jacopomaroli/multisensor/pcb/prj_img/front3D.png

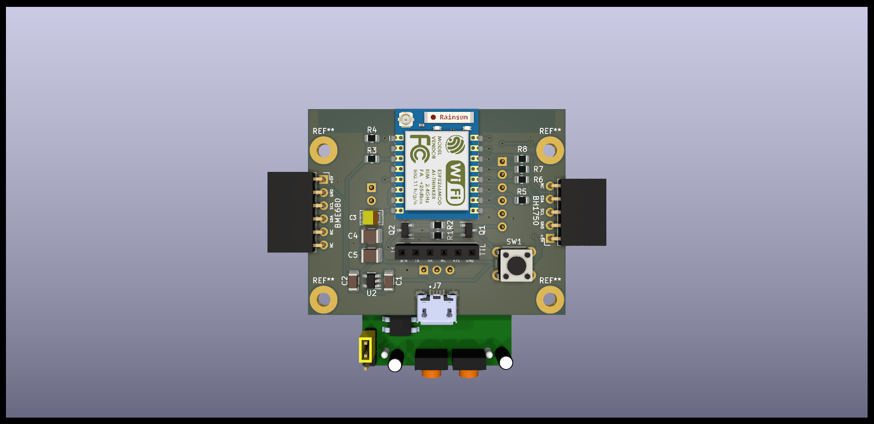
pcb/prj_img/front3D.png
