jacopomaroli/multisensor/pcb/prj_img/back3D_no_modules.png

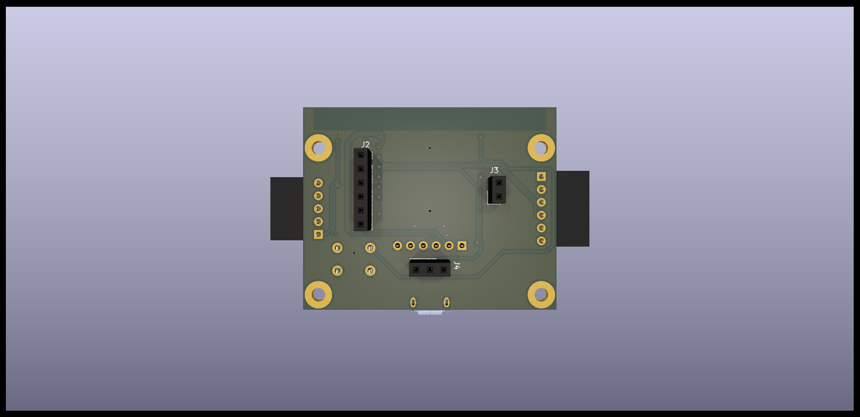
pcb/prj_img/back3D_no_modules.png
