jacopomaroli/multisensor/README.md

# Multisensor
This is a domotic project aimed to detect presence, temperature and light level in a room and share data with the rest of the ecosystem (e.g. homeassistant)

# Notes
VDO/CS of BME680 should be connected to GND
https://github.com/esphome/issues/issues/2421
