jacopomaroli/multisensor/pcb/notes.md

# Notes

Official KiCAD library has MMBT3904 symbol with the right SOT23 footprint, that is the smd variand of 2n3904
