jacopomaroli/multisensor/pcb/prj_img/back3D.png

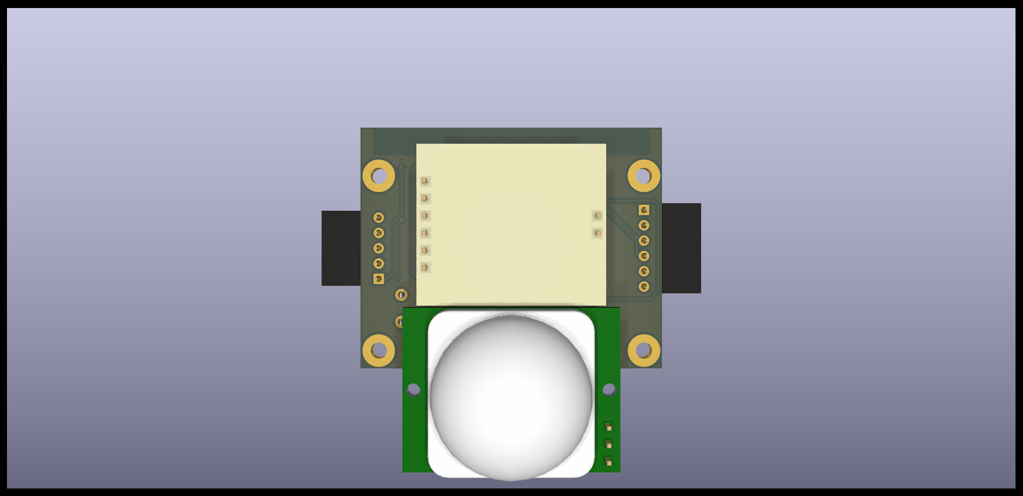
pcb/prj_img/back3D.png
