jacopomaroli/multisensor/pcb/prj_img/multisensor-B_Cu.png

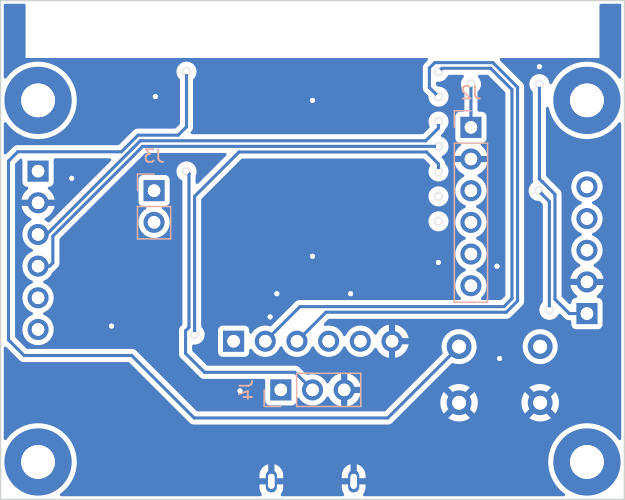
pcb/prj_img/multisensor-B_Cu.png
