jacopomaroli/multisensor/pcb/prj_img/multisensor-F_Cu.png

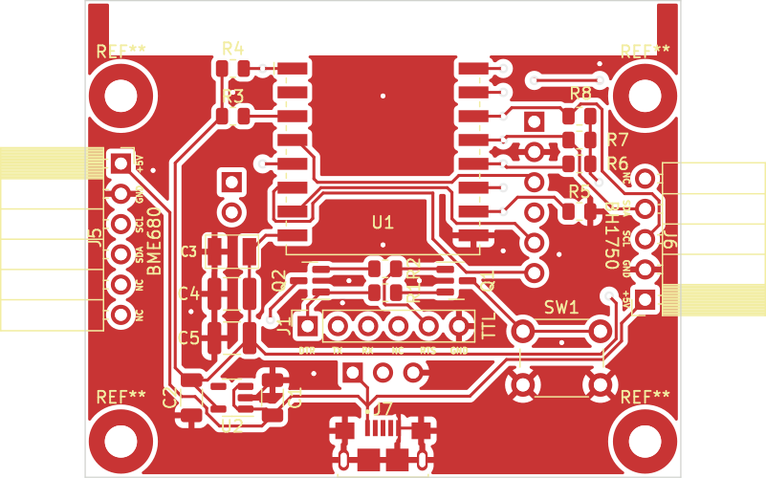
pcb/prj_img/multisensor-F_Cu.png
