jacopomaroli/multisensor/pcb/prj_img/multisensor.png

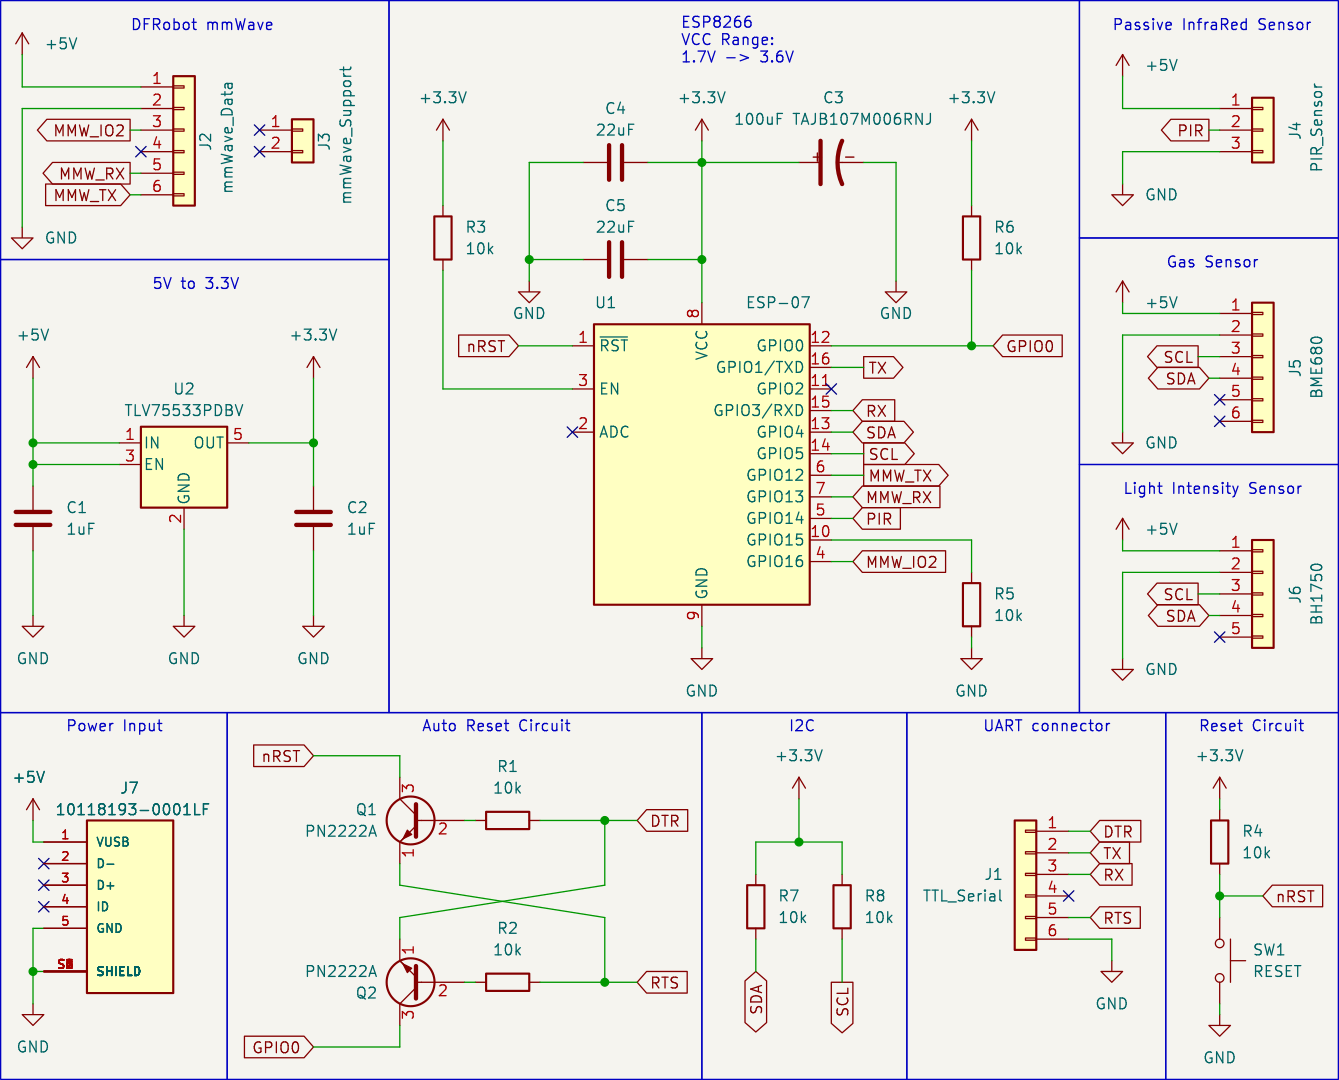
pcb/prj_img/multisensor.png
