jacopomaroli/multisensor/pcb/spice/sim1.png

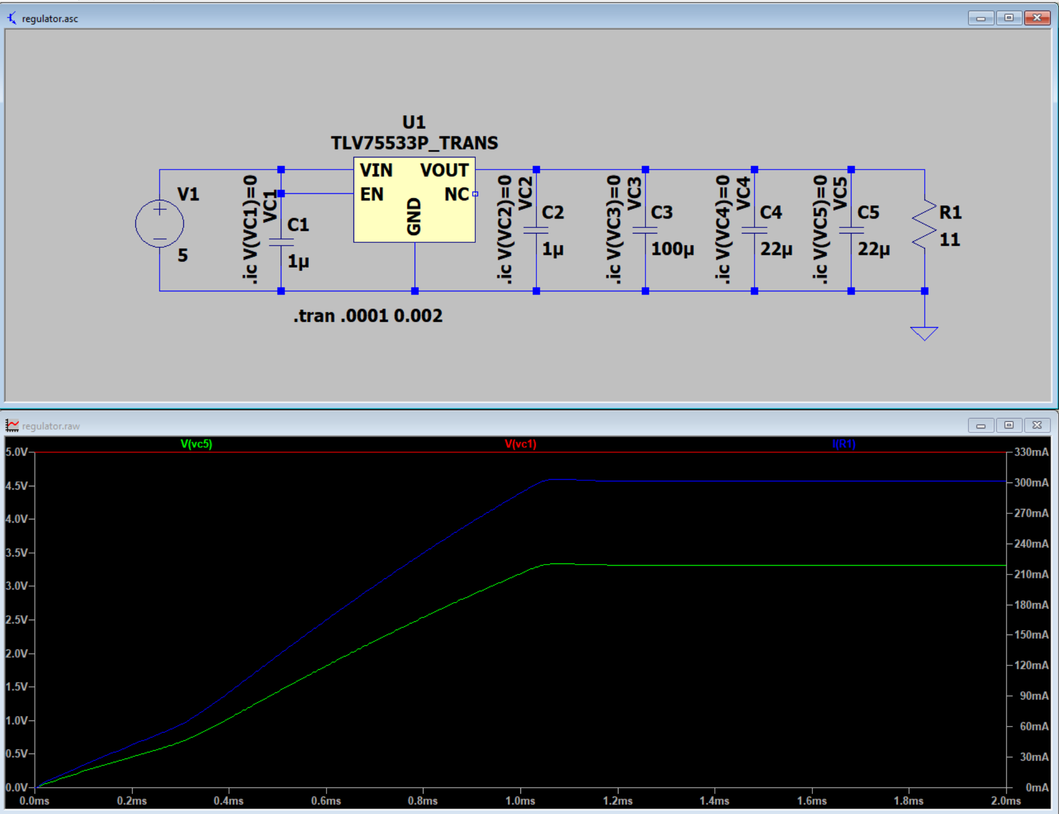
pcb/spice/sim1.png
