jacopomaroli/multisensor/pcb/spice/sim2.png

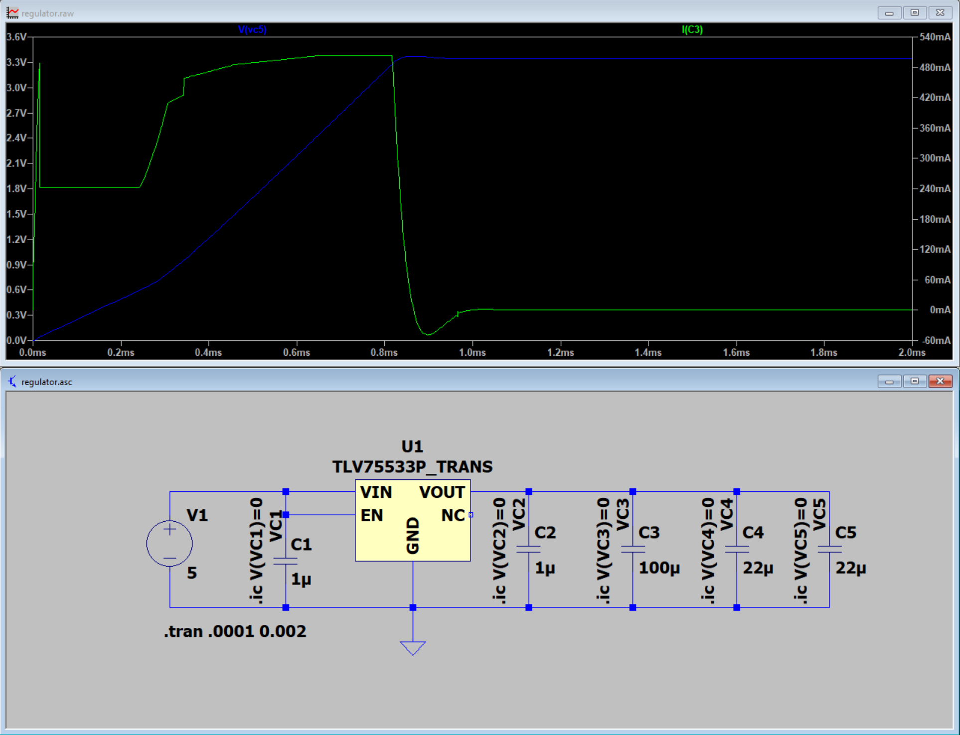
pcb/spice/sim2.png
