jacopomaroli/multisensor/pcb/spice/sim3.png

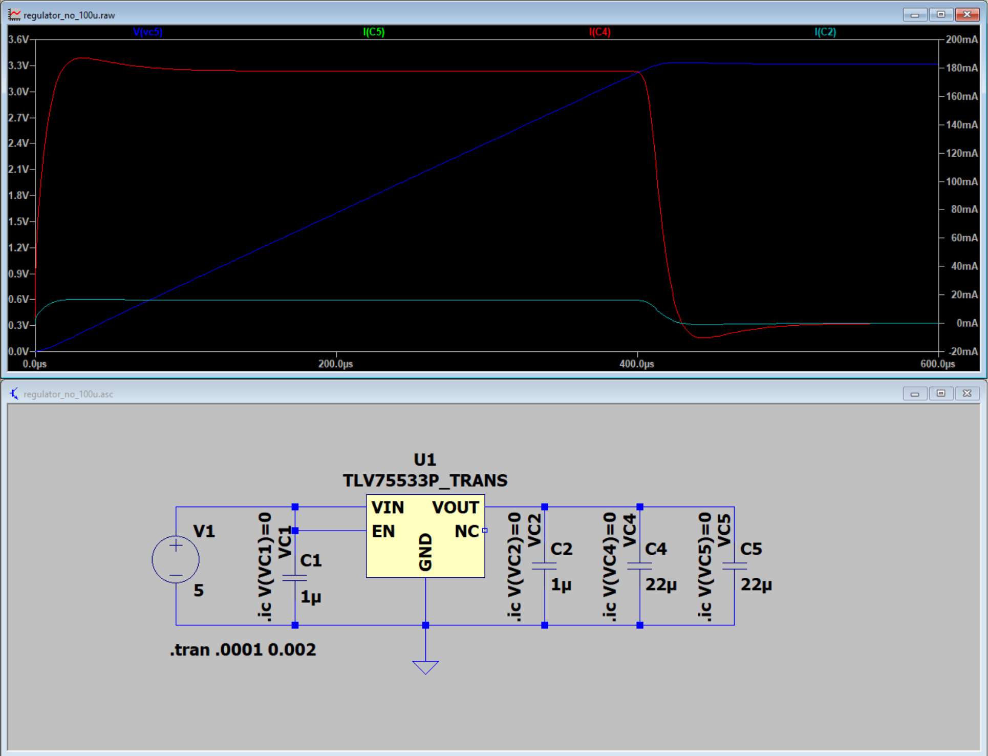
pcb/spice/sim3.png
