jacopomaroli/multisensor/pcb/spice/sim4.png

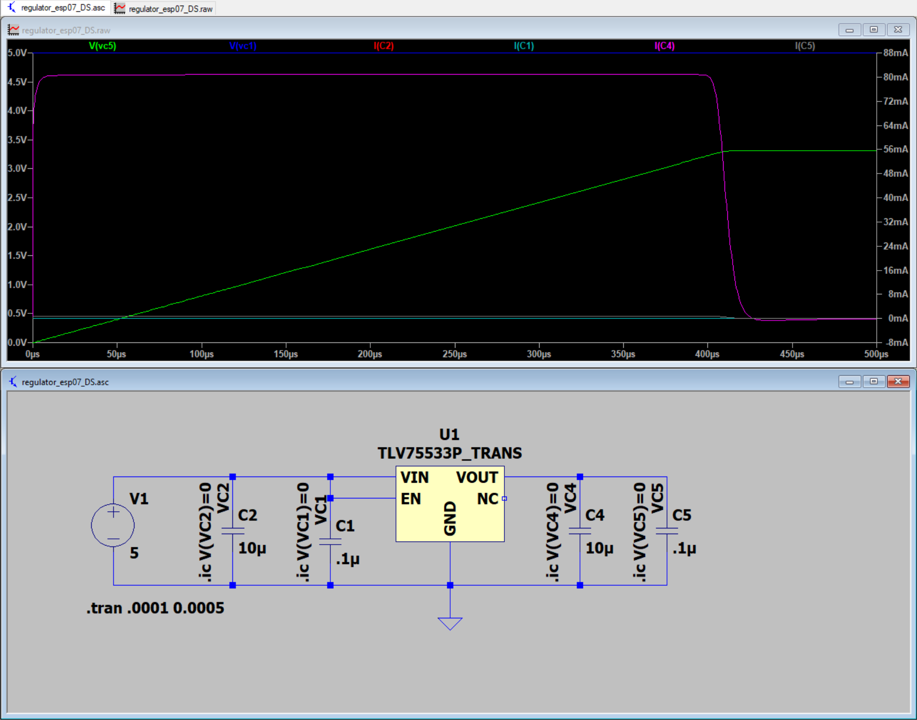
pcb/spice/sim4.png
