jacopomaroli/multisensor/pcb/spice/sim5.png

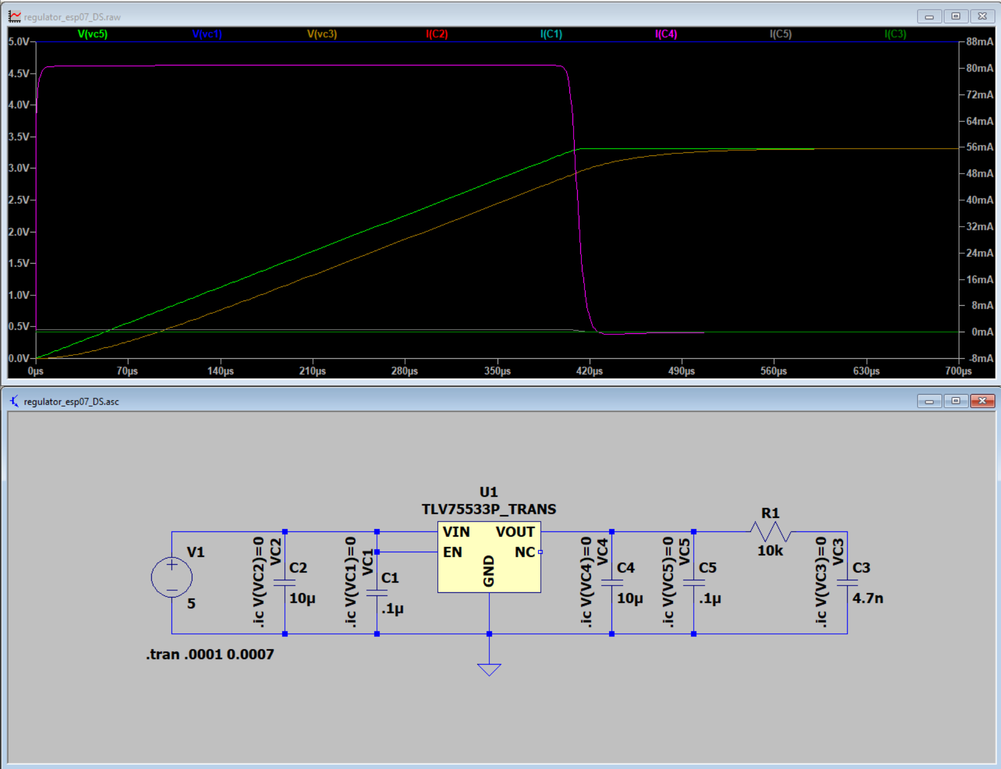
pcb/spice/sim5.png
