jacopomaroli/multisensor/pcb/theory/esp07-power.png

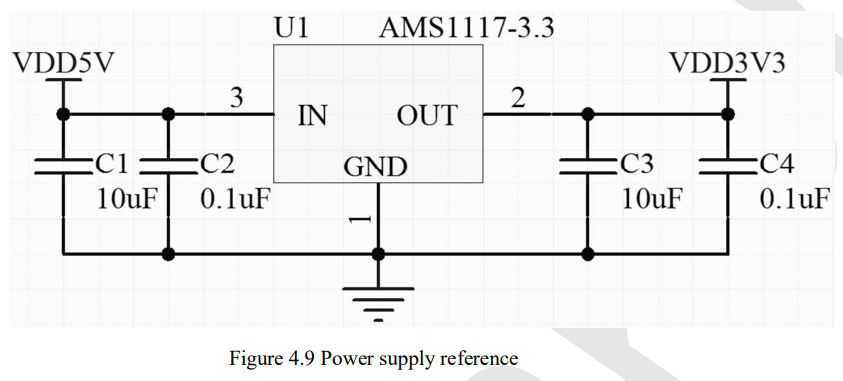
pcb/theory/esp07-power.png
