jacopomaroli/multisensor/pcb/theory/TLV755P-power.png

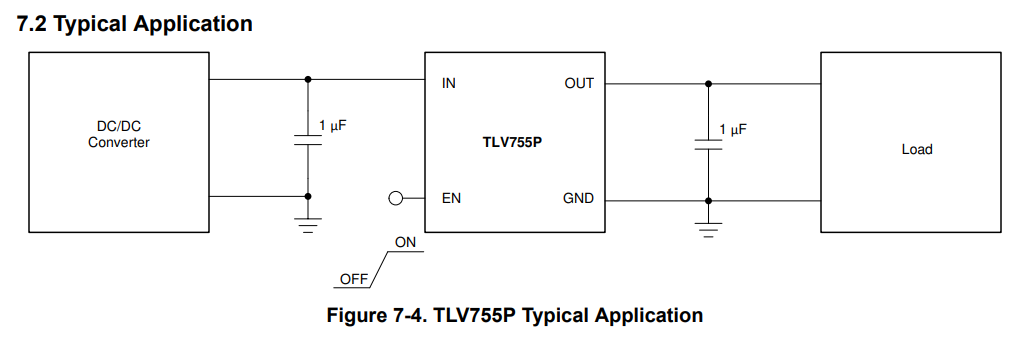
pcb/theory/TLV755P-power.png
