jacopomaroli/multisensor/pcb/spice/regulator.asc

C1: cap; 1µ
C2: cap; 1µ; V=50 Cpar=0.000001
C3: cap; 100µ
C4: cap; 22µ
C5: cap; 22µ
U1: TLV75533P_TRANS
V1: voltage; 5
Named nets: VC1, VC2, 0, VC3, VC4, VC5
.tran .0001 0.002
.ic V(VC1)=0
.ic V(VC2)=0
.ic V(VC3)=0
.ic V(VC4)=0
.ic V(VC5)=0
