jacopomaroli/multisensor/pcb/spice/regulator_esp07_DS.asc

C1: cap; .1µ
C2: cap; 10µ; V=50 Cpar=0.000001
C3: cap; .1µ
C4: cap; 10µ
C5: cap; .1µ
R1: res; 10k
U1: TLV75533P_TRANS
V1: voltage; 5
Named nets: VC1, VC2, 0, VC4, VC5, VC3
.tran .0001 0.01
.ic V(VC1)=0
.ic V(VC2)=0
.ic V(VC4)=0
.ic V(VC5)=0
.ic V(VC3)=0
