jacopomaroli/multisensor/pcb/multisensor/multisensor.kicad_pcb

## KiCad design pcb/multisensor/multisensor.kicad_pcb (2024-01-05)

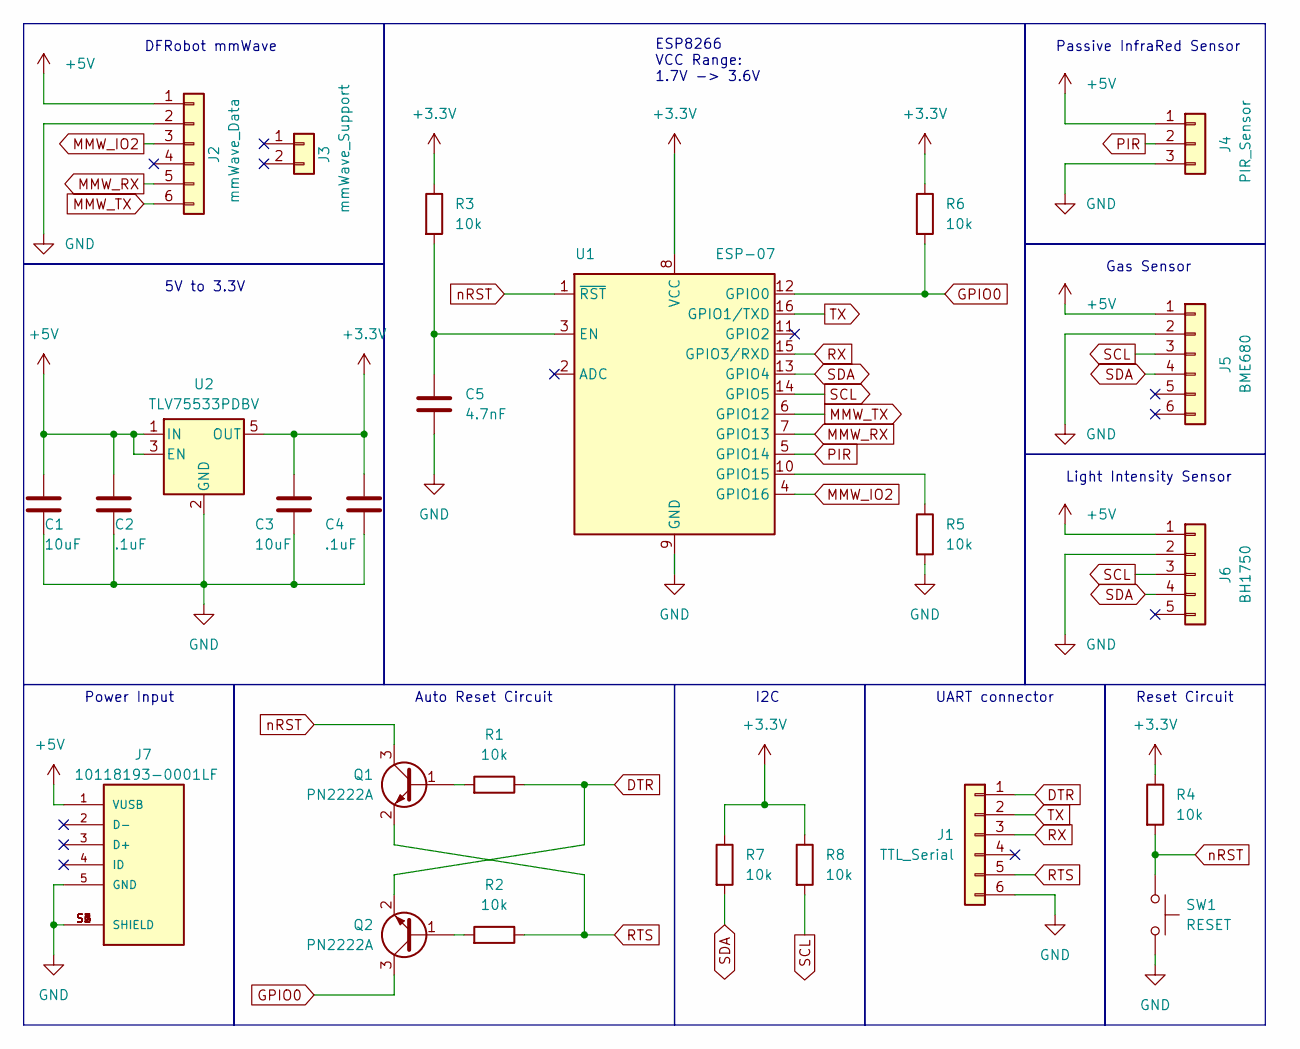
[picture p14: schematic multisensor.kicad_sch]

Parts:
C1, C3: 10uF; C_1206_3216Metric; MPN CL31B106KAHNNNE
C2, C4: .1uF; C_1206_3216Metric; MPN C1206C104K5RAC7800
C5: 4.7nF; C_1206_3216Metric; MPN KGM31TR72D472KU
J1: TTL_Serial; PinSocket_1x06_P2.54mm_Vertical; MPN PPPC061LFBN-RC
J2: mmWave_Data; PinSocket_1x06_P2.54mm_Vertical; MPN PPPC061LFBN-RC
J3: mmWave_Support; PinSocket_1x02_P2.54mm_Vertical; MPN PPPC021LFBN-RC
J4: PIR_Sensor; PinSocket_1x03_P2.54mm_Vertical; MPN PPPC031LFBN-RC
J5: BME680; PinSocket_1x06_P2.54mm_Horizontal; MPN PPPC061LGBN-RC
J6: BH1750; PinSocket_1x05_P2.54mm_Horizontal; MPN PPPC051LGBN-RC
J7: 10118193-0001LF; AMPHENOL_10118193-0001LF; PARTREV E; DigiKey_Part_Number 609-4616-2-ND
Q1, Q2: PN2222A; SOT-23; MPN MMBT2222A-TP
R1, R2, R3, R4, R5, R6, R7, R8: 10k; R_0805_2012Metric; MPN RMCF0805FT10K0
SW1: RESET; SW_PUSH_6mm; MPN TS02-66-60-BK-160-LCR-D
U1: ESP-07; MPN ESP-07
U2: TLV75533PDBV; SOT-23-5; MPN TLV75533PDBVR

Connections:
+3.3V: C3.1, C4.1, R3.1, R4.1, R6.1, R7.1, R8.1, U1.8 (VCC), U2.5 (OUT)
+5V: C1.1, C2.1, J2.1, J4.1, J5.1, J6.1, J7.1 (VUSB), U2.1 (IN), U2.3 (EN)
DTR: J1.1, Q2.2 (E), R1.1
GND: C1.2, C2.2, C3.2, C4.2, C5.2, J1.6, J2.2, J4.3, J5.2, J6.2, J7.5 (GND), J7.S1 (SHIELD), J7.S2 (SHIELD), J7.S3 (SHIELD), J7.S4 (SHIELD), J7.S5 (SHIELD), J7.S6 (SHIELD), R5.2, SW1.2, U1.9 (GND), U2.2 (GND)
GPIO0: Q2.3 (C), R6.2, U1.12 (GPIO0)
MMW_IO2: J2.3, U1.4 (GPIO16)
MMW_RX: J2.5, U1.7 (GPIO13)
MMW_TX: J2.6, U1.6 (GPIO12)
unnamed: Q1.1 (B), R1.2
unnamed: Q2.1 (B), R2.2
unnamed: C5.1, R3.2, U1.3 (EN)
unnamed: R5.1, U1.10 (GPIO15)
PIR: J4.2, U1.5 (GPIO14)
RTS: J1.5, Q1.2 (E), R2.1
RX: J1.3, U1.15 (GPIO3/RXD)
SCL: J5.3, J6.3, R8.2, U1.14 (GPIO5)
SDA: J5.4, J6.4, R7.2, U1.13 (GPIO4)
TX: J1.2, U1.16 (GPIO1/TXD)
nRST: Q1.3 (C), R4.2, SW1.1, U1.1 (~RST)

Notes on the sheet:
Light Intensity Sensor
DFRobot mmWave
Auto Reset Circuit
Reset Circuit
ESP8266 VCC Range: 1.7V -> 3.6V
Gas Sensor
Power Input
Passive InfraRed Sensor
UART connector
I2C
5V to 3.3V

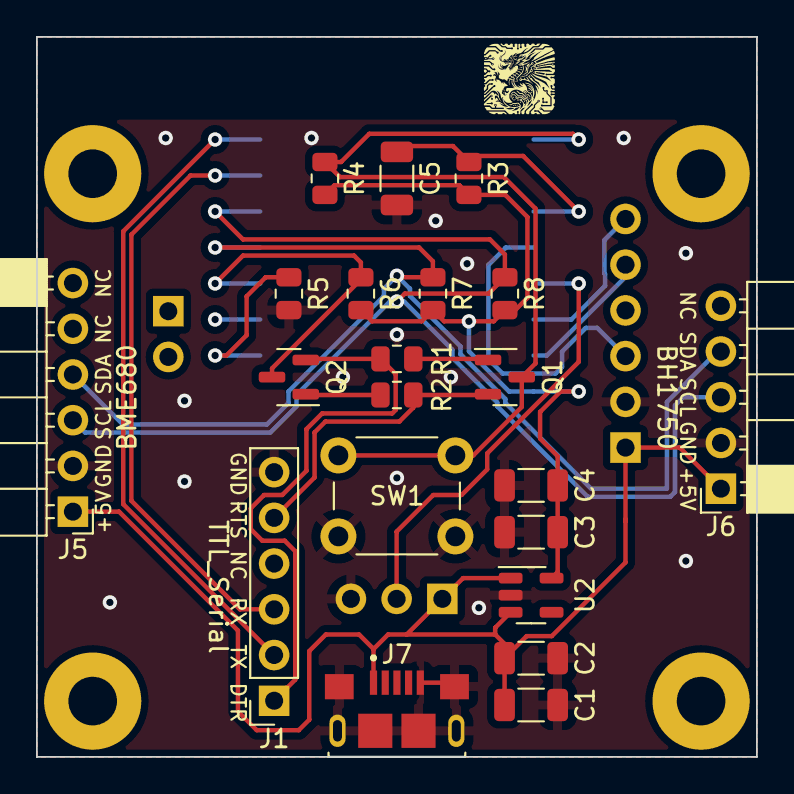
[picture p15: board multisensor.kicad_pcb from above]

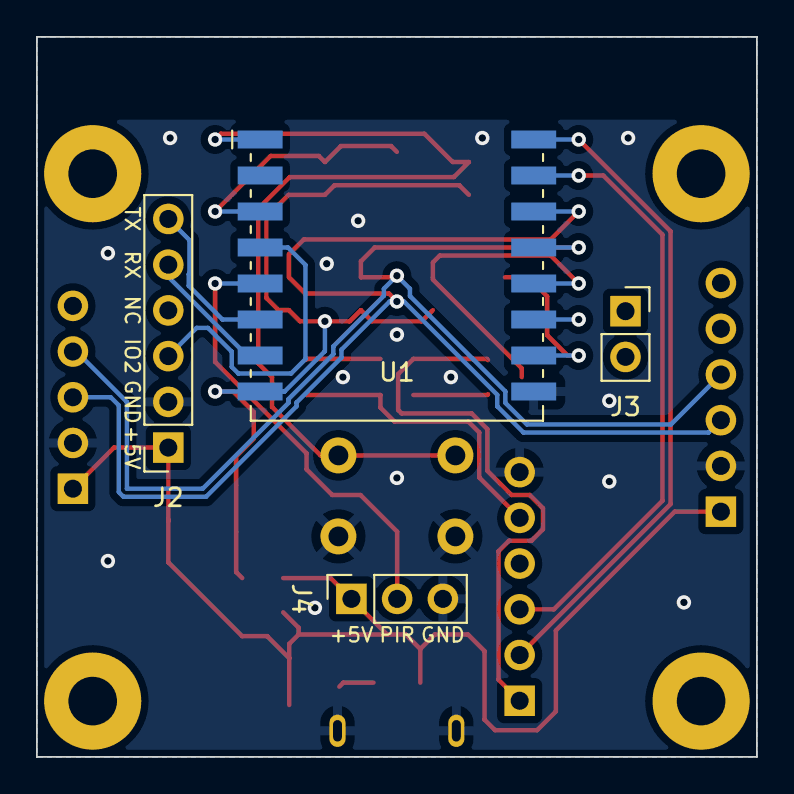
[picture p16: board multisensor.kicad_pcb from below]

Board: 2 copper layers, 40.0 x 40.0 mm, 25 parts (4 on the bottom side), 19 nets.
