jacopomaroli/multisensor/(commit log)

2023-10-22 update esp-7 model
    [multisensor.kicad_pcb]
2023-10-22 improve pir model
    [multisensor.kicad_pcb]
2023-10-26 fix vcc/gnd pointing up/down
    [multisensor.kicad_sch]
2023-10-26 board images
    [multisensor.kicad_pcb]
2023-11-23 add tantalum caps to VCC
    [multisensor.kicad_pcb, multisensor.kicad_sch]
2023-11-24 update prj_img
    [multisensor.kicad_pcb]
2023-11-26 add filtering caps + external pullups
    [multisensor.kicad_pcb, multisensor.kicad_sch]
2023-11-30 upadate regulator and connector
    [multisensor.kicad_pcb, multisensor.kicad_sch]
2023-12-05 add spice simulations and manufacturing files
    [multisensor-B_Cu.gbr, multisensor-B_Mask.gbr, multisensor-B_Paste.gbr, multisensor-B_Silkscreen.gbr, multisensor-Edge_Cuts.gbr, multisensor-F_Cu.gbr, multisensor-F_Mask.gbr, multisensor-F_Paste.gbr]
2023-12-05 update gerber files
    [multisensor-B_Cu.gbr, multisensor-B_Mask.gbr, multisensor-B_Paste.gbr, multisensor-B_Silkscreen.gbr, multisensor-Edge_Cuts.gbr, multisensor-F_Cu.gbr, multisensor-F_Mask.gbr, multisensor-F_Paste.gbr]
2023-12-05 update gerber output path
    [multisensor.kicad_pcb]
2023-12-28 fix pcb layout
    [multisensor.kicad_pcb, multisensor.kicad_sch]
2024-01-05 finalize v0.2.0
    [multisensor.kicad_pcb]
